KhoiPham2402/RISCV-VPU32x/report/acronyms.tex

%% acronyms.tex — Abbreviations used in the thesis
\newacronym{vpu}{VPU}{Vector Processing Unit}
\newacronym{isa}{ISA}{Instruction Set Architecture}
\newacronym{risc}{RISC}{Reduced Instruction Set Computer}
\newacronym{riscv}{RISC-V}{Reduced Instruction Set Computer V}
\newacronym{rtl}{RTL}{Register Transfer Level}
\newacronym{asic}{ASIC}{Application-Specific Integrated Circuit}
\newacronym{fpga}{FPGA}{Field-Programmable Gate Array}
\newacronym{rvv}{RVV}{RISC-V Vector Extension}
\newacronym{vlen}{VLEN}{Vector Register Length}
\newacronym{sew}{SEW}{Standard Element Width}
\newacronym{lmul}{LMUL}{Length MULtiplier}
\newacronym{vlmax}{VLMAX}{Maximum Vector Length}
\newacronym{vrf}{VRF}{Vector Register File}
\newacronym{vl}{VL}{Vector Length}
\newacronym{fsm}{FSM}{Finite State Machine}
\newacronym{fifo}{FIFO}{First-In First-Out}
\newacronym{lsu}{LSU}{Load/Store Unit}
\newacronym{vlsu}{VLSU}{Vector Load/Store Unit}
\newacronym{alu}{ALU}{Arithmetic Logic Unit}
\newacronym{uart}{UART}{Universal Asynchronous Receiver-Transmitter}
\newacronym{dmem}{DMEM}{Data Memory}
\newacronym{imem}{IMEM}{Instruction Memory}
\newacronym{csr}{CSR}{Control and Status Register}
\newacronym{simd}{SIMD}{Single Instruction Multiple Data}
\newacronym{agu}{AGU}{Address Generation Unit}
\newacronym{fmax}{Fmax}{Maximum Operating Frequency}
\newacronym{alm}{ALM}{Adaptive Logic Module}
\newacronym{sta}{STA}{Static Timing Analysis}
\newacronym{pnr}{PnR}{Place and Route}
\newacronym{drc}{DRC}{Design Rule Check}
\newacronym{lvs}{LVS}{Layout vs.\ Schematic}
\newacronym{gds}{GDS}{Graphic Design System}
\newacronym{hcmut}{HCMUT}{Ho Chi Minh City University of Technology}
\newacronym{tlu}{TL-UL}{TileLink Uncached Lightweight}
\newacronym{raw}{RAW}{Read After Write}
\newacronym{waw}{WAW}{Write After Write}
