KhoiPham2402/RISCV-VPU32x/fpga/sim/vga_frame_full.png

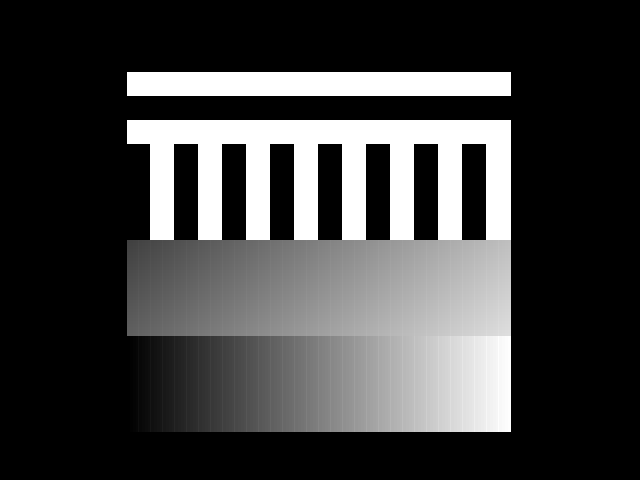
fpga/sim/vga_frame_full.png
