KhoiPham2402/RISCV-VPU32x/fpga/sim/vga_image_128.png

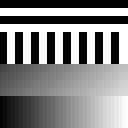
fpga/sim/vga_image_128.png
