KhoiPham2402/RISCV-VPU32x/image/vrf.png

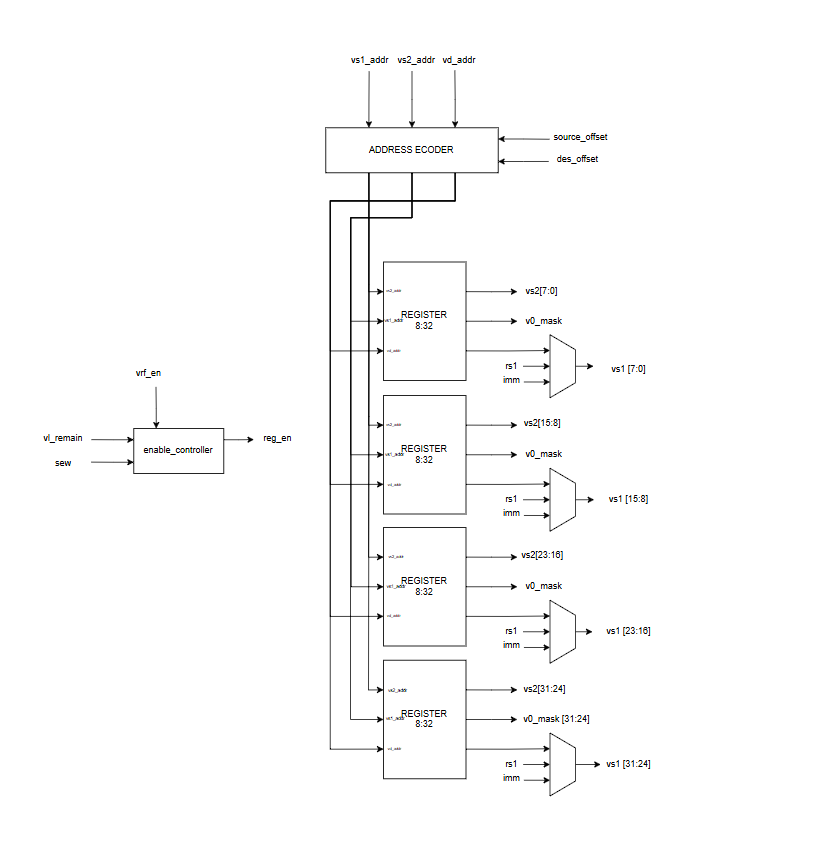
image/vrf.png
