KhoiPham2402/RISCV-VPU32x/report/charts/00_dashboard.png

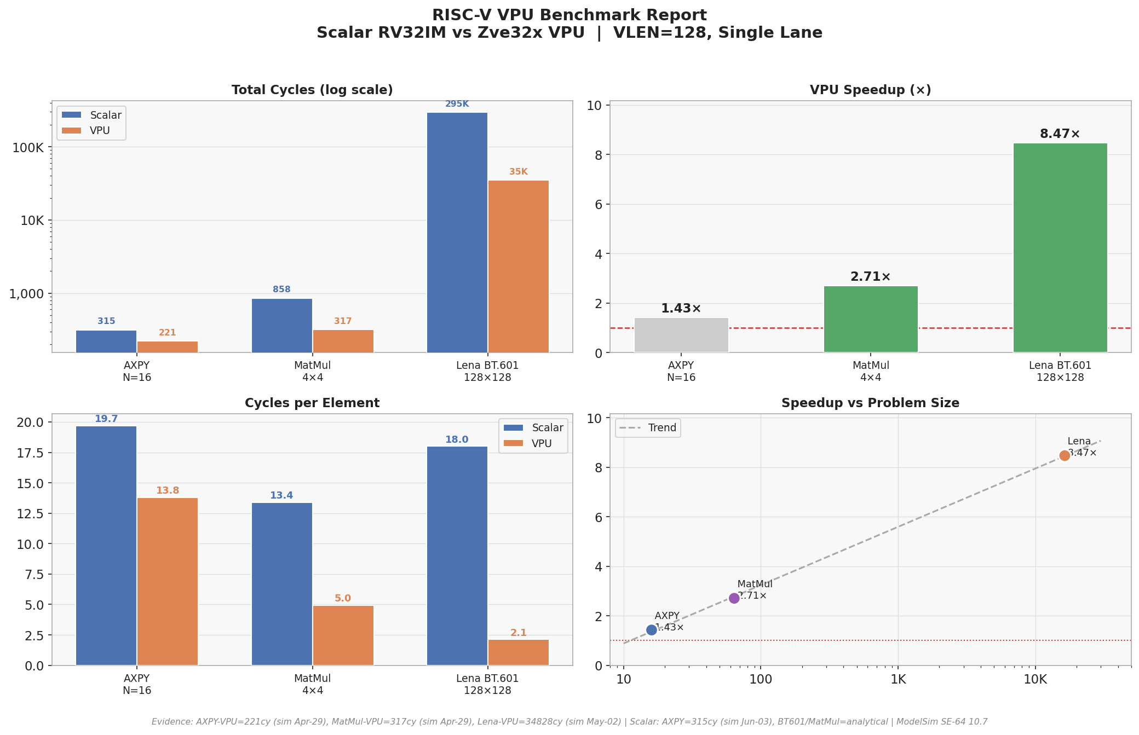
report/charts/00_dashboard.png
