KhoiPham2402/RISCV-VPU32x/report/charts/01_cycles_comparison.png

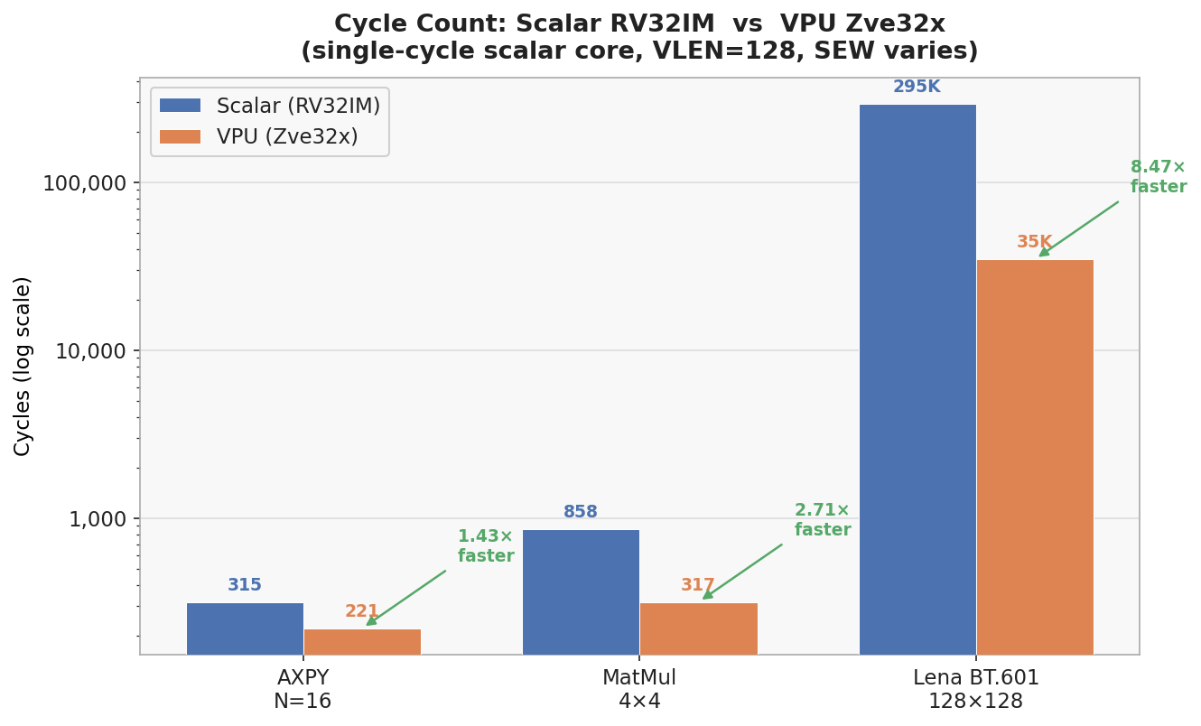
report/charts/01_cycles_comparison.png
