KhoiPham2402/RISCV-VPU32x/report/charts/02_speedup.png

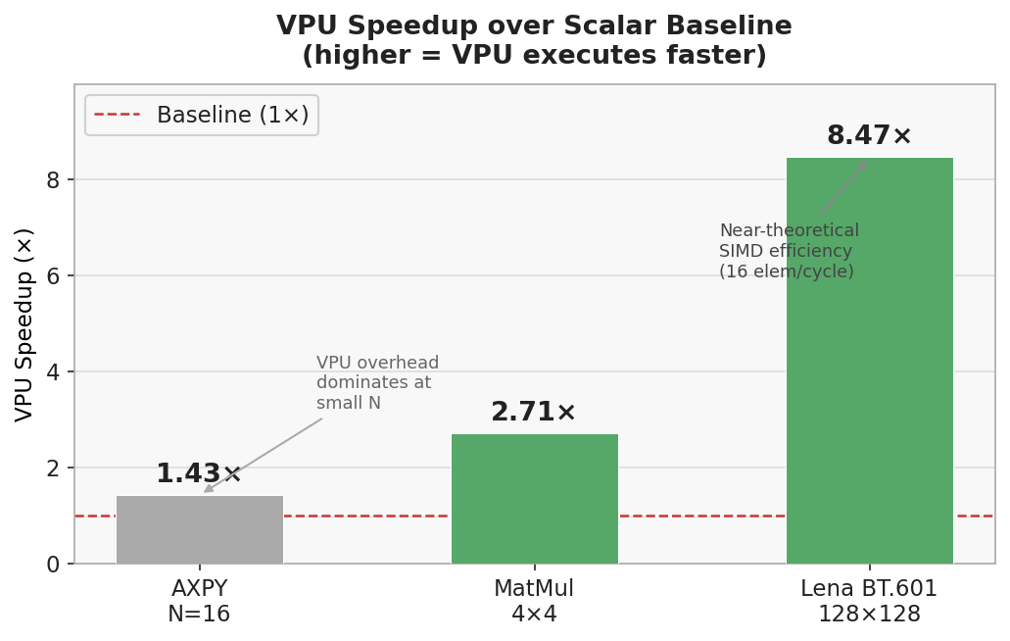
report/charts/02_speedup.png
