KhoiPham2402/RISCV-VPU32x/report/charts/03_throughput_per_elem.png

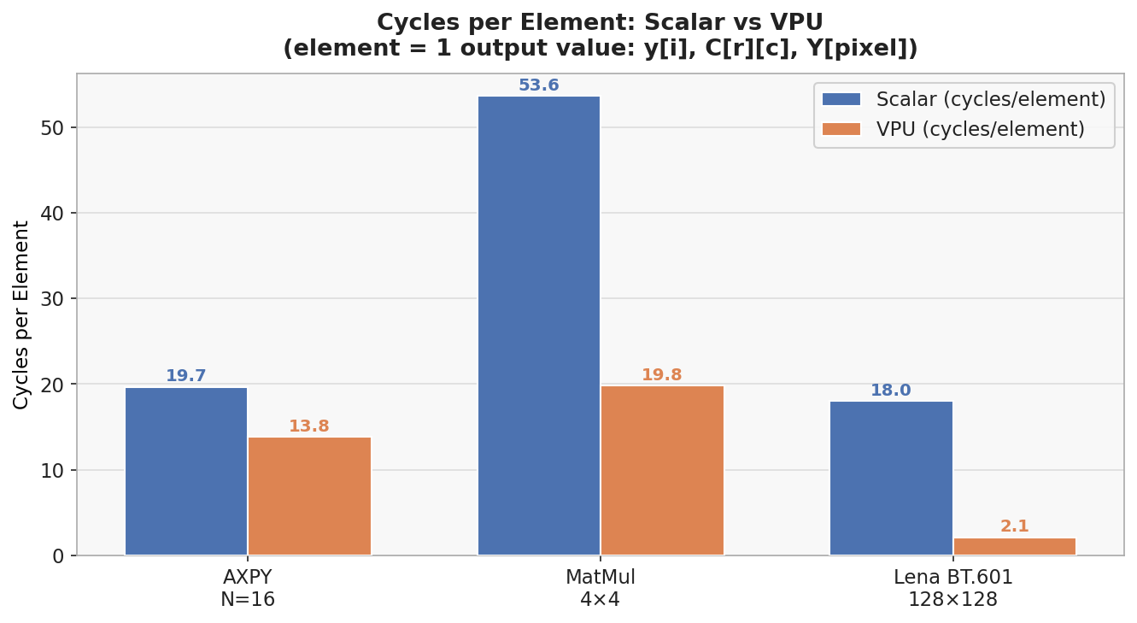
report/charts/03_throughput_per_elem.png
