KhoiPham2402/RISCV-VPU32x/report/charts/04_lena_breakdown.png

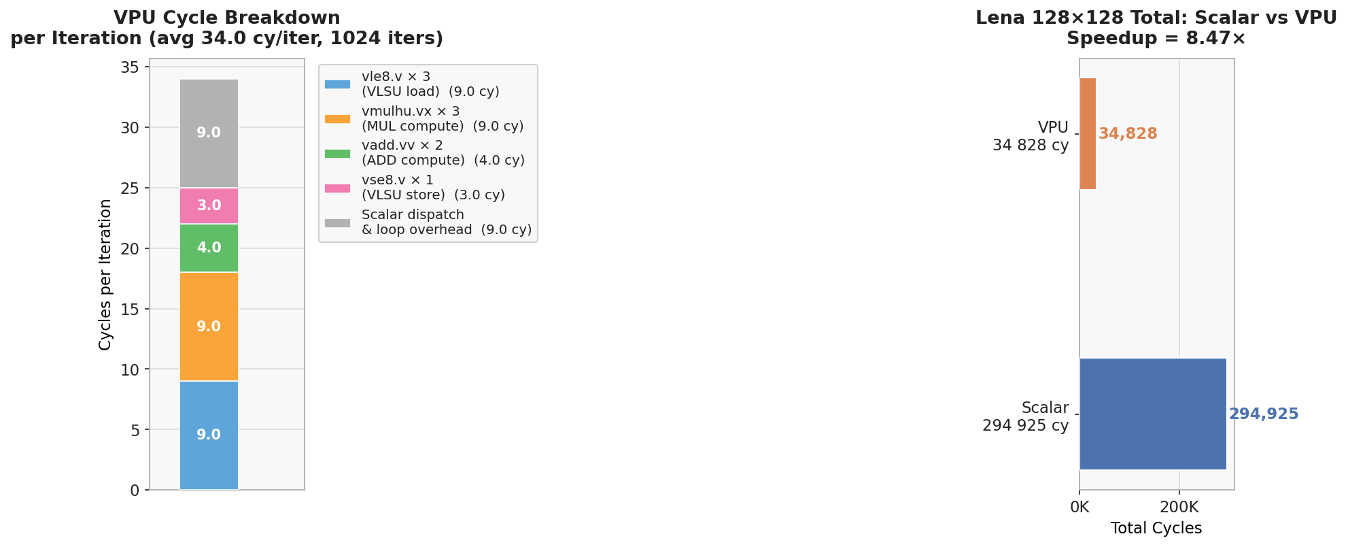
report/charts/04_lena_breakdown.png
