KhoiPham2402/RISCV-VPU32x/report/charts/05_speedup_vs_size.png

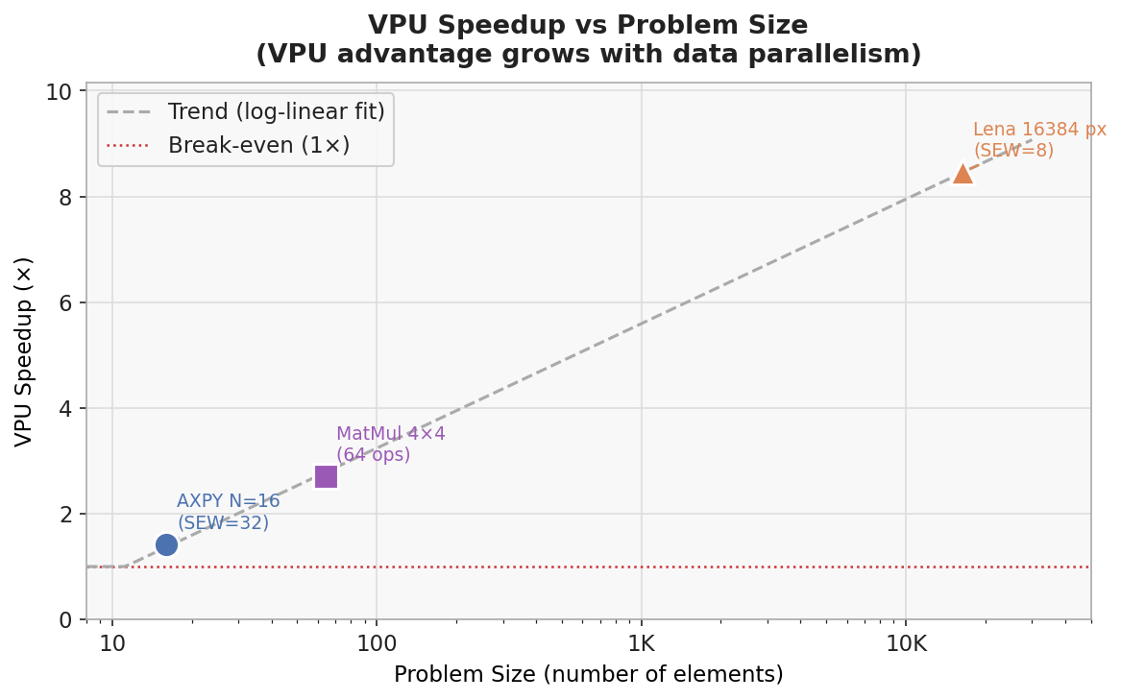
report/charts/05_speedup_vs_size.png
