KhoiPham2402/RISCV-VPU32x/report/image/dmem_lena_flow.png

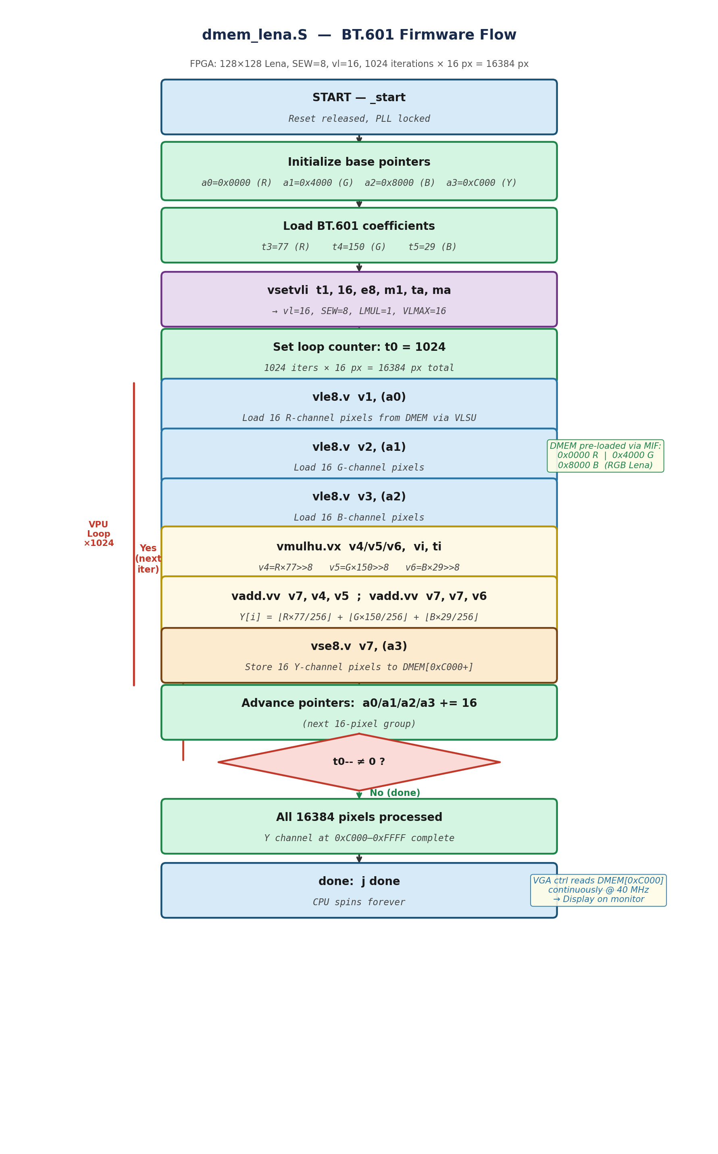
report/image/dmem_lena_flow.png
