KhoiPham2402/RISCV-VPU32x/report/charts/06_instruction_count.png

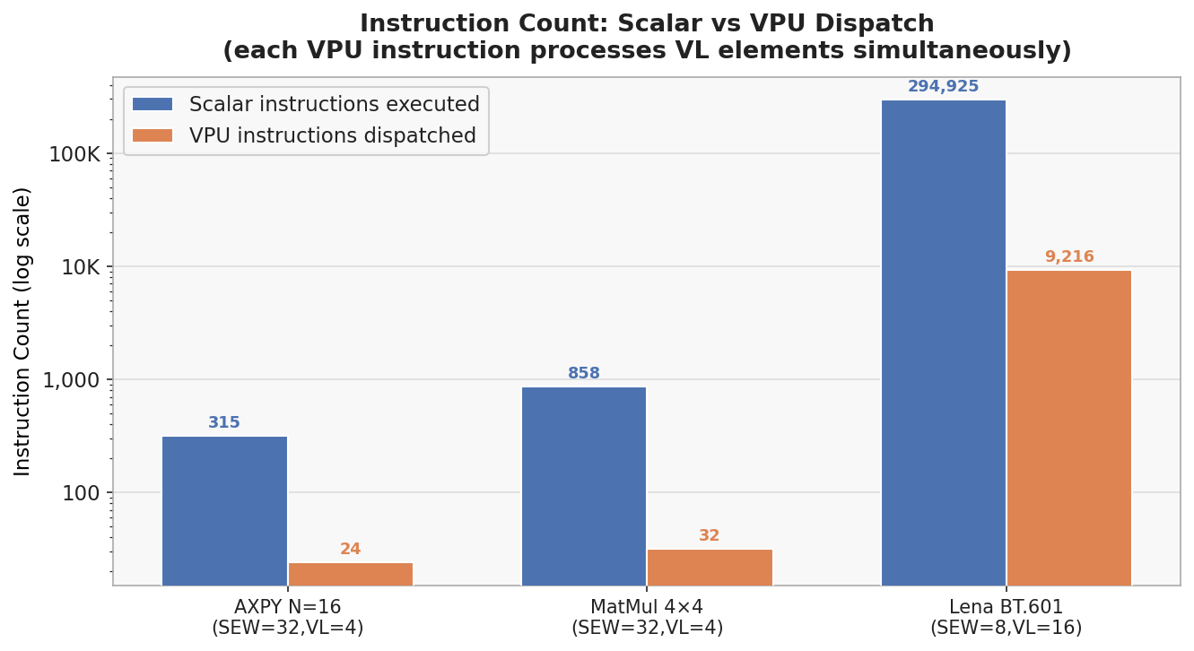
report/charts/06_instruction_count.png
