KhoiPham2402/RISCV-VPU32x/sw/benchmarks/pathfinder/README.md

# Pathfinder — NOT SUPPORTED

Pathfinder requires vslide1up.vx and vslide1down.vx (RVV section 16.3).
These instructions are part of the Zve32x subset but are NOT implemented
in this RTL version.

Status: blocked — see PROJECT_STATUS.md issue #13.
