KhoiPham2402/RISCV-VPU32x/bench/simulation_result.txt

# 
========================================
Compiling RTL modules...
========================================

Compiling testbench...
========================================

Starting simulation...
========================================
# do run_tb_lane.do
# ** Warning: (vlib-34) Library already exists at "work".
# Model Technology ModelSim - Intel FPGA Edition vmap 10.5b Lib Mapping Utility 2016.10 Oct  5 2016
# vmap work work 
# Copying C:/intelFPGA_lite/18.1/modelsim_ase/win32aloem/../modelsim.ini to modelsim.ini
# Modifying modelsim.ini
# Model Technology ModelSim - Intel FPGA Edition vlog 10.5b Compiler 2016.10 Oct  5 2016
# Start time: 22:01:40 on Mar 14,2026
# vlog -sv ../rtl/vproc_adder.sv 
# -- Compiling module vproc_adder
# 
# Top level modules:
# 	vproc_adder
# End time: 22:01:41 on Mar 14,2026, Elapsed time: 0:00:01
# Errors: 0, Warnings: 0
# Model Technology ModelSim - Intel FPGA Edition vlog 10.5b Compiler 2016.10 Oct  5 2016
# Start time: 22:01:41 on Mar 14,2026
# vlog -sv ../rtl/vproc_mul.sv 
# -- Compiling module vproc_mul
# 
# Top level modules:
# 	vproc_mul
# End time: 22:01:41 on Mar 14,2026, Elapsed time: 0:00:00
# Errors: 0, Warnings: 0
# Model Technology ModelSim - Intel FPGA Edition vlog 10.5b Compiler 2016.10 Oct  5 2016
# Start time: 22:01:41 on Mar 14,2026
# vlog -sv ../rtl/vproc_logic.sv 
# -- Compiling module vproc_logic
# 
# Top level modules:
# 	vproc_logic
# End time: 22:01:41 on Mar 14,2026, Elapsed time: 0:00:00
# Errors: 0, Warnings: 0
# Model Technology ModelSim - Intel FPGA Edition vlog 10.5b Compiler 2016.10 Oct  5 2016
# Start time: 22:01:41 on Mar 14,2026
# vlog -sv ../rtl/vproc_shifter.sv 
# -- Compiling module vproc_shifter
# 
# Top level modules:
# 	vproc_shifter
# End time: 22:01:41 on Mar 14,2026, Elapsed time: 0:00:00
# Errors: 0, Warnings: 0
# Model Technology ModelSim - Intel FPGA Edition vlog 10.5b Compiler 2016.10 Oct  5 2016
# Start time: 22:01:41 on Mar 14,2026
# vlog -sv ../rtl/vproc_compare.sv 
# -- Compiling module vproc_compare
# 
# Top level modules:
# 	vproc_compare
# End time: 22:01:41 on Mar 14,2026, Elapsed time: 0:00:00
# Errors: 0, Warnings: 0
# Model Technology ModelSim - Intel FPGA Edition vlog 10.5b Compiler 2016.10 Oct  5 2016
# Start time: 22:01:41 on Mar 14,2026
# vlog -sv ../rtl/vproc_processor_lane.sv 
# -- Compiling module vproc_processor_lane
# ** Error: (vlog-13069) ../rtl/vproc_processor_lane.sv(216): near ",": syntax error, unexpected ',', expecting '}'.
# ** Error: (vlog-13069) ../rtl/vproc_processor_lane.sv(221): near ",": syntax error, unexpected ',', expecting '}'.
# End time: 22:01:41 on Mar 14,2026, Elapsed time: 0:00:00
# Errors: 2, Warnings: 0
# ** Error: C:/intelFPGA_lite/18.1/modelsim_ase/win32aloem/vlog failed.
# Error in macro ./run_tb_lane.do line 16
# C:/intelFPGA_lite/18.1/modelsim_ase/win32aloem/vlog failed.
#     while executing
# "vlog -sv ../rtl/vproc_processor_lane.sv"
# Model Technology ModelSim - Intel FPGA Edition vlog 10.5b Compiler 2016.10 Oct  5 2016
# Start time: 22:01:41 on Mar 14,2026
# vlog -sv tb_vproc_lane.sv 
# -- Compiling module tb_vproc_lane
# ** Error: (vlog-13069) tb_vproc_lane.sv(269): near ",": syntax error, unexpected ',', expecting '}'.
# ** Error: (vlog-13069) tb_vproc_lane.sv(284): near ",": syntax error, unexpected ',', expecting '}'.
# End time: 22:01:41 on Mar 14,2026, Elapsed time: 0:00:00
# Errors: 2, Warnings: 0
# ** Error: C:/intelFPGA_lite/18.1/modelsim_ase/win32aloem/vlog failed.
# Error in macro ./run_tb_lane.do line 21
# C:/intelFPGA_lite/18.1/modelsim_ase/win32aloem/vlog failed.
#     while executing
# "vlog -sv tb_vproc_lane.sv"
# vsim -novopt work.tb_vproc_lane 
# Start time: 22:01:39 on Mar 14,2026
# ** Error: (vsim-3170) Could not find 'tb_vproc_lane'.
#         Searched libraries:
#             C:/CapstoneProject2/riscv_vpu/bench/work
# ** Error: Error loading design
# Error in macro ./run_tb_lane.do line 26
# Error loading design
#     while executing
# "vsim -novopt work.tb_vproc_lane"

Running testbench...
# No Design Loaded!
# Error in macro ./run_tb_lane.do line 30
# 
#     while executing
# "run -all"

Simulation completed!
# End time: 22:01:41 on Mar 14,2026, Elapsed time: 0:00:02
# Errors: 14, Warnings: 1
