KhoiPham2402/RISCV-VPU32x/sw/benchmarks/lena_gray/lena_comparison.png

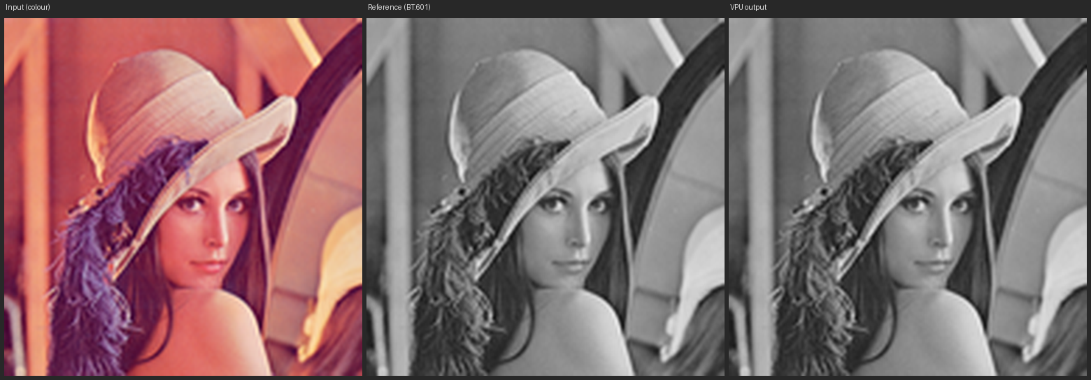
sw/benchmarks/lena_gray/lena_comparison.png
