KhoiPham2402/RISCV-VPU32x/sw/benchmarks/sobel/sobel_comparison.png

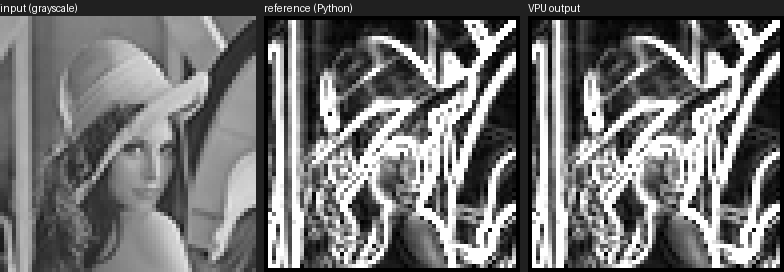
sw/benchmarks/sobel/sobel_comparison.png
