KhoiPham2402/RISCV-VPU32x/fpga/rtl/vpu/vproc_system_wrapper.sv

// Top-level wrapper tích hợp:
//   decoder -> fifo -> fsm
//   cfg_encoder + cycle_counter + 4x vregfile + 4x processor_lane + vcsr
//
// vmask16 = cửa sổ mask sau mux structural (vproc_mask_enable).
// v0_flat ghép 128b từ mask_data v0 của 4 lane; mask_cycle_idx từ cycle_counter.

module vproc_system_wrapper #(
    parameter NUM_REGS   = 32,
    parameter ADDR_WIDTH = 5,
    parameter CTRL_WIDTH = 49
) (
    input                   clk,
    input                   rst_n,

    // Issue interface
    input                   instr_valid,
    input  [31:0]           instruction,
    input  [31:0]           rs1_scalar_data, // avl / rs1 scalar
    input  [31:0]           rs2_scalar_data, // dùng cho vsetvl lấy vtype từ rs2

    // VRF write control
    input                   vrf_commit_en,

    // Outputs debug/quan sát
    output [3:0]            cycles,
    output [15:0]           vmask16,
    output                  fifo_full,
    output                  busy,
    output [3:0]            fsm_state,
    output [31:0]           wb_result_lane0,
    output [31:0]           wb_result_lane1,
    output [31:0]           wb_result_lane2,
    output [31:0]           wb_result_lane3,

    // Handshake back to scalar core
    output                  vpu_ready,

    // Config writeback (vl remaining for scalar rd)
    output                  vpu_cfg_done,
    output [31:0]           vpu_vl_remain,

    // CSR vector (debug / quan sát thanh ghi)
    output [31:0]           csr_vl_o,
    output [31:0]           csr_vtype_o,
    output [31:0]           csr_vlenb_o,

    // Cổng đọc CSR theo địa chỉ (từ scalar inst[31:20])
    input  [11:0]           scalar_csr_addr,
    output [31:0]           scalar_csr_rdata,

    // ── VLSU shared DMEM bus (routed to secondary port of scalar lsu.sv) ──
    output                  vlsu_mem_req,
    output                  vlsu_mem_we,
    output [31:0]           vlsu_mem_addr,
    output [ 3:0]           vlsu_mem_be,
    output [31:0]           vlsu_mem_wdata,
    input  [31:0]           vlsu_mem_rdata,
    input                   vlsu_mem_ready,  // from dmem_sync vlsu_ready (1-cyc read latency ack)

    // VLSU status (for stall signaling back to scalar core via vpu_ready)
    output                  vlsu_busy_o
);

    // ===== Decoder -> FIFO =====
    wire [CTRL_WIDTH-1:0] dec_ctrl_bus;
    wire                  dec_valid;
    wire [31:0]           dec_imm_out;

    wire [CTRL_WIDTH-1:0] fifo_ctrl_out;
    wire [31:0]           fifo_rs1_out;
    wire [31:0]           fifo_imm_out;
    wire                  fifo_data_valid;

    // ===== FSM signals =====
    wire fsm_latch_ctrl_en;
    wire fsm_csr_cfg_en;
    wire fsm_counter_start;
    wire fsm_vrf_wren;
    wire fsm_widen_sel;
    wire fsm_s_offset_en;
    wire fsm_d_offset_en;
    wire fsm_offset_reset;
    wire fsm_pop_ready;
    wire fsm_reduction_start;
    wire fsm_reduction_en;
    wire red_busy;

    // ===== Latched instruction/context (chốt bởi FSM) =====
    reg [CTRL_WIDTH-1:0] ctrl_r;
    reg [31:0]           rs1_latched_r;
    reg [31:0]           imm_latched_r;

    // Field extraction từ ctrl_r
    wire [ADDR_WIDTH-1:0] vs1_addr_base_r = ctrl_r[4:0];
    wire [ADDR_WIDTH-1:0] vs2_addr_base_r = ctrl_r[9:5];
    wire [ADDR_WIDTH-1:0] vd_addr_base_r  = ctrl_r[14:10];
    wire [5:0]            funct6_r   = ctrl_r[20:15];
    wire                  is_widen_r = ctrl_r[21];
    wire                  is_u_vs1_r = ctrl_r[22];
    wire                  is_u_vs2_r = ctrl_r[23];
    wire                  sub_r      = ctrl_r[24];
    wire                  use_imm_r  = ctrl_r[25];
    wire                  use_rs1_r  = ctrl_r[26];
    wire                  is_mulh_r  = ctrl_r[27];
    wire                  vm_r       = ctrl_r[31];
    wire [7:0]            vtype_enc_r = ctrl_r[39:32];
    wire                  is_carry_r      = ctrl_r[40];
    wire                  is_mask_carry_r = ctrl_r[41];
    wire                  is_masking_r    = ctrl_r[42];
    wire                  is_final_masking_r = ctrl_r[43];
    wire                  is_reverse_sub_r   = ctrl_r[44];
    wire                  minmax_is_min_r    = ctrl_r[45];
    wire                  minmax_is_unsign_r = ctrl_r[46];
    wire                  is_reduction_r     = ctrl_r[47];

    // ===== CFG encoder outputs =====
    wire [31:0] cfg_vl;
    wire [31:0] cfg_vlmax;
    wire [2:0]  cfg_sew;
    wire        cfg_vill;
    wire [31:0] cfg_avl_remain;

    // ===== Cycle counter related =====
    wire       counter_done;
    wire [3:0] cycles_left_dbg;
    wire [7:0] elems_curr_cycle_dbg;
    wire [15:0] cycle_mask16_dbg;
    wire [3:0]  mask_cycle_idx;

    // ===== VRF read data per lane =====
    wire [31:0] rs1_data_lane0, rs2_data_lane0;
    wire [31:0] rs1_data_lane1, rs2_data_lane1;
    wire [31:0] rs1_data_lane2, rs2_data_lane2;
    wire [31:0] rs1_data_lane3, rs2_data_lane3;
    wire [31:0] mask_data_lane0, mask_data_lane1, mask_data_lane2, mask_data_lane3;
    wire [127:0] v0_mask_flat = {mask_data_lane3, mask_data_lane2,
                                  mask_data_lane1, mask_data_lane0};

    // ===== Internal writeback per lane =====
    wire [31:0] wb_lane0, wb_lane1, wb_lane2, wb_lane3;
    wire [3:0]  lane_mask_result0, lane_mask_result1, lane_mask_result2, lane_mask_result3;
    wire [3:0]  lane_mask0, lane_mask1, lane_mask2, lane_mask3;
    wire [3:0]  lane_we0, lane_we1, lane_we2, lane_we3;
    wire [31:0] lane0_v0_merge_bits, lane1_v0_merge_bits, lane2_v0_merge_bits, lane3_v0_merge_bits;
    wire [ADDR_WIDTH-1:0] vs1_addr_eff, vs2_addr_eff, vd_addr_eff;
    wire [31:0] imm_elem_vec;
    wire [31:0] rs1_elem_vec;
    wire        is_compare_r = (funct6_r[5:3] == 3'b011);
    wire [127:0] mask_buffer_data;
    wire [6:0]   mask_wr_ptr_dbg;
    wire         final_masking_commit = (fsm_state == 3'd6) && is_final_masking_r;
    wire         reduction_commit = (fsm_state == 4'd8) && is_reduction_r;
    wire [127:0] rs1_vec_flat = {rs1_data_lane3, rs1_data_lane2, rs1_data_lane1, rs1_data_lane0};
    wire [127:0] rs2_vec_flat = {rs2_data_lane3, rs2_data_lane2, rs2_data_lane1, rs2_data_lane0};
    wire [31:0]  reduction_result;
    wire         reduction_wb_valid;
    reg [3:0]    reduction_operation;
    localparam [3:0] RED_SUM  = 4'd0;
    localparam [3:0] RED_MAX  = 4'd1;
    localparam [3:0] RED_MAXU = 4'd2;
    localparam [3:0] RED_MIN  = 4'd3;
    localparam [3:0] RED_MINU = 4'd4;
    localparam [3:0] RED_AND  = 4'd5;
    localparam [3:0] RED_OR   = 4'd6;
    localparam [3:0] RED_XOR  = 4'd7;
    // Final masking: commit toàn bộ 128-bit buffer về 4 lane (mỗi lane 32-bit).
    wire [31:0]  wb_lane0_mux = final_masking_commit ? mask_buffer_data[31:0]    : wb_lane0;
    wire [31:0]  wb_lane1_mux = final_masking_commit ? mask_buffer_data[63:32]   : wb_lane1;
    wire [31:0]  wb_lane2_mux = final_masking_commit ? mask_buffer_data[95:64]   : wb_lane2;
    wire [31:0]  wb_lane3_mux = final_masking_commit ? mask_buffer_data[127:96]  : wb_lane3;
    wire [3:0]   lane_we0_mux = final_masking_commit ? 4'b1111 : (lane_we0 & cycle_mask16_dbg[3:0]);
    wire [3:0]   lane_we1_mux = final_masking_commit ? 4'b1111 : (lane_we1 & cycle_mask16_dbg[7:4]);
    wire [3:0]   lane_we2_mux = final_masking_commit ? 4'b1111 : (lane_we2 & cycle_mask16_dbg[11:8]);
    wire [3:0]   lane_we3_mux = final_masking_commit ? 4'b1111 : (lane_we3 & cycle_mask16_dbg[15:12]);

    // =========================================================================
    // VLSU — Vector Load/Store Unit signals
    // =========================================================================

    // VLS instruction decode (combinational, parallel to FIFO path for OP-V)
    // LOAD-FP opcode [6:2] = 5'b00001  (0000111)
    // STORE-FP opcode [6:2] = 5'b01001 (0100111)
    wire is_vls_load_raw  = (instruction[6:2] == 5'b00001);
    wire is_vls_store_raw = (instruction[6:2] == 5'b01001);
    wire is_vls_unit_stride = (instruction[27:26] == 2'b00);    // mop=00 (unit-stride)
    wire is_vls_regular     = (instruction[24:20] == 5'b00000); // lumop/sumop=00000 (regular)
    wire is_vls_insn = (is_vls_load_raw || is_vls_store_raw) && is_vls_unit_stride && is_vls_regular;

    // Convert instruction width field [14:12] to 2-bit SEW encoding
    //   000 → e8  (sew=0), 101 → e16 (sew=1), 110 → e32 (sew=2)
    reg [1:0] vls_sew_dec;
    always_comb begin
        case (instruction[14:12])
            3'b000:  vls_sew_dec = 2'd0;
            3'b101:  vls_sew_dec = 2'd1;
            3'b110:  vls_sew_dec = 2'd2;
            default: vls_sew_dec = 2'd2;
        endcase
    end

    // ── Dispatcher hazard signals (forward-declared; resolved when FSM/addrgen elaborate) ──
    wire vlsu_busy_int;     // from VLSU instance
    wire vlsu_busy_store_int;
    wire fifo_or_fsm_busy = fifo_data_valid || busy;

    // WAW guard: block load from firing while OP-V FSM is writing OR has a pending
    // instruction in the FIFO that targets the same vd.
    // Gap in original: busy=0 when FIFO has instruction but FSM hasn't latched it yet,
    // allowing a load to fire in the same cycle the FSM transitions to ST_EXEC.
    // Fix: when FSM is idle but FIFO has data, compare against FIFO head vd (fifo_ctrl_out[14:10]).
    wire [4:0] pending_vd_addr = busy ? vd_addr_eff : fifo_ctrl_out[14:10];
    wire load_waw_stall = instr_valid && is_vls_load_raw
                          && is_vls_unit_stride && is_vls_regular
                          && (busy || fifo_data_valid)
                          && (pending_vd_addr == instruction[11:7]);

    // CSR stall: a load sees stale csr_vl_o=0 if vsetvli is still in FSM or FIFO.
    // Declared here (before vls_fire) because both vls_fire and vpu_ready use it.
    wire vsetvli_pending   = fsm_csr_cfg_en || (fifo_data_valid && fifo_ctrl_out[28]);
    wire is_load_csr_stall = instr_valid && is_vls_load_raw && vsetvli_pending;

    // Dispatcher: fire VLSU when:
    //   - instruction valid, recognised VLS, VLSU free
    //   - STORE: OP-V pipeline fully drained (WAR: vs2 port no longer hijacked)
    //   - LOAD:  OP-V FSM not writing same vd (WAW: VRF write-port conflict)
    //   - LOAD:  vsetvli not pending (CSR stall guard — see is_load_csr_stall)
    wire vls_fire = instr_valid && is_vls_insn && !vlsu_busy_int
                    && (!is_vls_store_raw || !fifo_or_fsm_busy)
                    && !load_waw_stall
                    && !is_load_csr_stall;

    // Track whether the running VLSU op is a load (for VRF vs2 mux)
    reg vlsu_is_load_r;
    always_ff @(posedge clk) begin
        if (!rst_n)         vlsu_is_load_r <= 1'b1;
        else if (vls_fire)  vlsu_is_load_r <= is_vls_load_raw;
    end

    // VLSU VRF writeback wires — declared here so scoreboard can reference them
    wire        vlsu_vrf_we;
    wire [4:0]  vlsu_vrf_waddr;

    // ── Scoreboard: RAW hazard (OP-V reads register being loaded by VLSU) ──
    // vrf_busy_r[i]=1 means VRF[i] has an in-flight VLSU load writing to it.
    // FSM must not execute any OP-V instruction whose vs1/vs2 is marked busy.
    reg [31:0] vrf_busy_r;
    always_ff @(posedge clk) begin
        if (!rst_n) begin
            vrf_busy_r <= 32'b0;
        end else begin
            if (vls_fire && is_vls_load_raw)
                vrf_busy_r[instruction[11:7]] <= 1'b1;   // mark load dest busy
            if (vlsu_vrf_we)
                vrf_busy_r[vlsu_vrf_waddr] <= 1'b0;      // clear when load commits
        end
    end

    // Head-of-FIFO source registers (ctrl_bus layout: vs1=[4:0], vs2=[9:5])
    wire [4:0] fifo_vs1_addr = fifo_ctrl_out[4:0];
    wire [4:0] fifo_vs2_addr = fifo_ctrl_out[9:5];
    wire [4:0] load_vd_addr  = instruction[11:7];

    // Same-cycle check: vrf_busy_r is registered so it won't reflect a load
    // that fires THIS cycle — catch it combinationally.
    wire cur_load_raw = vls_fire && is_vls_load_raw &&
                        (load_vd_addr == fifo_vs1_addr ||
                         load_vd_addr == fifo_vs2_addr);

    // RAW stall: hold FSM in ST_IDLE until the conflicting load finishes.
    wire raw_stall = fifo_data_valid &&
                     (vrf_busy_r[fifo_vs1_addr] ||
                      vrf_busy_r[fifo_vs2_addr] ||
                      cur_load_raw);
    wire [31:0] vlsu_vrf_wdata_l0, vlsu_vrf_wdata_l1;
    wire [31:0] vlsu_vrf_wdata_l2, vlsu_vrf_wdata_l3;

    // VRF vs2 address mux: during VLSU store, override with vlsu_vrf_raddr
    wire [4:0]  vlsu_vrf_raddr_int;
    wire [4:0]  vs2_addr_to_vrf = (vlsu_busy_int && !vlsu_is_load_r)
                                    ? vlsu_vrf_raddr_int
                                    : vs2_addr_eff;

    // VRF write-port mux: VLSU wins over ALU pipeline (FSM is idle during VLSU)
    wire [4:0]  vrf_waddr_eff   = vlsu_vrf_we ? vlsu_vrf_waddr   : vd_addr_eff;
    wire [31:0] vrf_wdata0_eff  = vlsu_vrf_we ? vlsu_vrf_wdata_l0
                                               : (reduction_commit ? reduction_result : wb_lane0_mux);
    wire [31:0] vrf_wdata1_eff  = vlsu_vrf_we ? vlsu_vrf_wdata_l1 : wb_lane1_mux;
    wire [31:0] vrf_wdata2_eff  = vlsu_vrf_we ? vlsu_vrf_wdata_l2 : wb_lane2_mux;
    wire [31:0] vrf_wdata3_eff  = vlsu_vrf_we ? vlsu_vrf_wdata_l3 : wb_lane3_mux;

    wire [3:0] vrf_we0_eff = vlsu_vrf_we ? 4'b1111
                           : ((vrf_commit_en && fsm_vrf_wren)
                              ? (reduction_commit ? 4'b1111 : lane_we0_mux) : 4'b0000);
    wire [3:0] vrf_we1_eff = vlsu_vrf_we ? 4'b1111
                           : ((vrf_commit_en && fsm_vrf_wren)
                              ? (reduction_commit ? 4'b0000 : lane_we1_mux) : 4'b0000);
    wire [3:0] vrf_we2_eff = vlsu_vrf_we ? 4'b1111
                           : ((vrf_commit_en && fsm_vrf_wren)
                              ? (reduction_commit ? 4'b0000 : lane_we2_mux) : 4'b0000);
    wire [3:0] vrf_we3_eff = vlsu_vrf_we ? 4'b1111
                           : ((vrf_commit_en && fsm_vrf_wren)
                              ? (reduction_commit ? 4'b0000 : lane_we3_mux) : 4'b0000);

    // ===== Decoder =====
    vproc_vdecoder #(
        .BASE_ADDR (ADDR_WIDTH),
        .CTRL_WIDTH(CTRL_WIDTH)
    ) decoder_inst (
        .instruction(instruction),
        .rs2_data   (rs2_scalar_data),
        .ctrl_bus   (dec_ctrl_bus),
        .imm_out    (dec_imm_out),
        .valid      (dec_valid)
    );

    // ===== FIFO =====
    vproc_fifo #(
        .CTRL_WIDTH(CTRL_WIDTH),
        .RS1_WIDTH (32),
        .IMM_WIDTH (32),
        .DEPTH     (8),
        .ADDR_W    (3)
    ) fifo_inst (
        .clk       (clk),
        .rst_n     (rst_n),
        // Config (vsetvli): push whenever FIFO has space — must not wait for vlsu_busy.
        // Arithmetic OP-V: only push when vpu_ready (prevents duplicate FIFO pushes on stall).
        .push_valid(instr_valid && dec_valid &&
                    (dec_ctrl_bus[28] ? ~fifo_full : vpu_ready)),
        .ctrl_in   (dec_ctrl_bus),
        .rs1_in    (rs1_scalar_data),
        .imm_in    (dec_imm_out),
        .full      (fifo_full),
        .ctrl_out  (fifo_ctrl_out),
        .rs1_out   (fifo_rs1_out),
        .imm_out   (fifo_imm_out),
        .data_valid(fifo_data_valid),
        .pop_ready (fsm_pop_ready)
    );

    // vpu_ready: stall scalar core for:
    //   - FIFO full (backpressure from OP-V queue)
    //   - VLSU busy (ongoing load or store)
    //   - STORE presented while OP-V pipeline draining (WAR guard)
    //   - LOAD presented while OP-V FSM writing same vd (WAW guard)
    //   - LOAD presented while vsetvli is pending (CSR stall guard):
    //     A vle*/vse* fires with csr_vl_o; if vsetvli is still in FSM (ST_CONFIG)
    //     or in the FIFO head, csr_vl_o may be stale (0 from reset). Stall the
    //     scalar so the load does not fire until VL is committed.
    wire is_store_stall = instr_valid && is_vls_store_raw
                          && is_vls_unit_stride && is_vls_regular
                          && fifo_or_fsm_busy;
    assign vpu_ready     = ~fifo_full && ~vlsu_busy_int
                           && ~is_store_stall && ~load_waw_stall
                           && ~is_load_csr_stall;
    assign vlsu_busy_o   = vlsu_busy_int;
    assign vpu_cfg_done  = fsm_csr_cfg_en;
    // Write actual vl (= min(avl, vlmax)) to scalar rd, NOT avl_remain.
    // avl_remain was the bug: for avl=16, vlmax=4 it gave 12 instead of 4.
    assign vpu_vl_remain = cfg_vl;

    // ===== FSM =====
    vproc_fsm fsm_inst (
        .clk          (clk),
        .rst_n        (rst_n),
        .instr_valid  (fifo_data_valid && !raw_stall),  // RAW stall gates FSM
        .is_config    (fifo_ctrl_out[28]),
        .is_masking   (fifo_ctrl_out[42]),
        .is_widen     (fifo_ctrl_out[21]),
        .is_reduction (fifo_ctrl_out[47]),
        .counter_done (counter_done),
        .reduction_done(reduction_wb_valid),
        .reduction_busy(red_busy),
        .latch_ctrl_en(fsm_latch_ctrl_en),
        .csr_cfg_en   (fsm_csr_cfg_en),
        .counter_start(fsm_counter_start),
        .vrf_wren     (fsm_vrf_wren),
        .widen_sel    (fsm_widen_sel),
        .s_offset_en  (fsm_s_offset_en),
        .d_offset_en  (fsm_d_offset_en),
        .offset_reset (fsm_offset_reset),
        .pop_ready    (fsm_pop_ready),
        .reduction_start(fsm_reduction_start),
        .reduction_en (fsm_reduction_en),
        .busy         (busy),
        .state_out    (fsm_state)
    );

    // Chốt control + scalar(avl/rs1) + immediate vào thanh ghi tạm
    // chỉ khi FSM phát latch_ctrl_en.
    always_ff @(posedge clk) begin
        if (!rst_n) begin
            ctrl_r       <= {CTRL_WIDTH{1'b0}};
            rs1_latched_r <= 32'd0;
            imm_latched_r <= 32'd0;
        end else if (fsm_latch_ctrl_en) begin
            ctrl_r       <= fifo_ctrl_out;
            rs1_latched_r <= fifo_rs1_out;
            imm_latched_r <= fifo_imm_out;
        end
    end

    // Expand imm và rs1 scalar theo sew (module dùng chung).
    vproc_scalar_expand imm_expand_inst (
        .data_in (imm_latched_r),
        .sew     (cfg_sew),
        .data_out(imm_elem_vec)
    );

    vproc_scalar_expand rs1_expand_inst (
        .data_in (rs1_latched_r),
        .sew     (cfg_sew),
        .data_out(rs1_elem_vec)
    );

    // EXEC dùng cấu hình đã lưu trong CSR; riêng lệnh CONFIG dùng vtype từ instruction hiện tại.
    wire [7:0] vtype_active = ctrl_r[28] ? vtype_enc_r : csr_vtype_o[7:0];

    // For vsetivli (ctrl_r[48]=1) the AVL is the 5-bit immediate in vs1_addr,
    // not the latched scalar rs1 register value.
    wire [31:0] cfg_avl_src = ctrl_r[48] ? {27'b0, ctrl_r[4:0]} : rs1_latched_r;

    // ===== Config encoder =====
    vproc_cfg_encoder cfg_enc_inst (
        .vtype_enc  (vtype_active),
        .avl        (cfg_avl_src),
        .vl         (cfg_vl),
        .vlmax      (cfg_vlmax),
        .avl_remain (cfg_avl_remain),
        .sew        (cfg_sew),
        .vill       (cfg_vill)
    );

    // ===== Cycle counter =====
    vproc_cycle_counter cycle_counter_inst (
        .clk            (clk),
        .rst_n          (rst_n),
        .start          (fsm_counter_start),
        .enable         (fsm_s_offset_en),
        // Use CSR vl for non-config ops; config never triggers counter_start so cfg_vl is unused there
        .vl             (csr_vl_o),
        .vsew           (vtype_active[5:3]),
        .vlmul          (vtype_active[2:0]),
        .cycles_total   (cycles),
        .cycles_left    (cycles_left_dbg),
        .elems_curr_cycle(elems_curr_cycle_dbg),
        .cycle_mask16   (cycle_mask16_dbg),
        .cycle_index    (mask_cycle_idx),
        .done           (counter_done)
    );

    // ===== VRF address generator =====
    // Địa chỉ nguồn/đích tự tăng theo LMUL group.
    // Với widening: vd dùng offset nhân đôi + chọn pha bởi widen_sel.
    vproc_vrf_addr_gen #(
        .ADDR_WIDTH(ADDR_WIDTH)
    ) vrf_addr_gen_inst (
        .clk         (clk),
        .rst_n       (rst_n),
        .s_offset_enable(fsm_s_offset_en),
        .d_offset_enable(fsm_d_offset_en),
        .offset_clear(fsm_offset_reset),
        .vs1_base    (vs1_addr_base_r),
        .vs2_base    (vs2_addr_base_r),
        .vd_base     (vd_addr_base_r),
        .vs1_addr    (vs1_addr_eff),
        .vs2_addr    (vs2_addr_eff),
        .vd_addr     (vd_addr_eff)
    );

    // ===== CSR (simple 3-register) =====
    // vtype_enc từ FIFO đã chốt + avl từ rs1_latched_r -> cfg_encoder tính vl.
    // Khi FSM ở CONFIG, cfg_en=1 và csr lưu lại vl + vtype.
    vproc_vcsr vcsr_inst (
        .clk          (clk),
        .rst_n        (rst_n),
        .cfg_en       (fsm_csr_cfg_en),
        .vl_in        (cfg_vl),
        .vtype_enc_in (vtype_enc_r),
        .csr_addr     (scalar_csr_addr),
        .csr_rdata    (scalar_csr_rdata),
        .vl_o         (csr_vl_o),
        .vtype_o      (csr_vtype_o),
        .vlenb_o      (csr_vlenb_o)
    );

    // ===== Mask logic (mux structural trên v0_flat + sew + cycle_index) =====
    wire [3:0] lane0_v0_carry, lane1_v0_carry, lane2_v0_carry, lane3_v0_carry;

    vproc_mask_enable mask_enable_inst (
        .v0_flat         (v0_mask_flat),
        .sew             (cfg_sew),
        .mask_cycle_idx  (mask_cycle_idx[2:0]),
        .vm              (vm_r),
        .mask16_window   (vmask16),
        .lane0_mask      (lane_mask0),
        .lane1_mask      (lane_mask1),
        .lane2_mask      (lane_mask2),
        .lane3_mask      (lane_mask3),
        .lane0_we        (lane_we0),
        .lane1_we        (lane_we1),
        .lane2_we        (lane_we2),
        .lane3_we        (lane_we3),
        .lane0_v0_carry  (lane0_v0_carry),
        .lane1_v0_carry  (lane1_v0_carry),
        .lane2_v0_carry  (lane2_v0_carry),
        .lane3_v0_carry  (lane3_v0_carry)
    );

    // ===== Split v0 128-bit cho 4 lane (phục vụ VMERGE) =====
    // sew=8b : mỗi lane nhận 4 bit liên tiếp trong từng block 16 bit:
    //          lane0 [3:0], lane1 [7:4], lane2 [11:8], lane3 [15:12], ...
    // sew=16b: mỗi lane nhận 2 bit liên tiếp trong từng block 8 bit.
    // sew=32b: mỗi lane nhận 1 bit trong từng block 4 bit.
    reg [31:0] lane0_v0_merge_bits_r, lane1_v0_merge_bits_r, lane2_v0_merge_bits_r, lane3_v0_merge_bits_r;
    integer i;
    always_comb begin
        lane0_v0_merge_bits_r = 32'b0;
        lane1_v0_merge_bits_r = 32'b0;
        lane2_v0_merge_bits_r = 32'b0;
        lane3_v0_merge_bits_r = 32'b0;

        case (cfg_sew)
            3'd0: begin
                for (i = 0; i < 32; i = i + 1) begin
                    lane0_v0_merge_bits_r[i] = v0_mask_flat[(i * 4) + 0];
                    lane1_v0_merge_bits_r[i] = v0_mask_flat[(i * 4) + 1];
                    lane2_v0_merge_bits_r[i] = v0_mask_flat[(i * 4) + 2];
                    lane3_v0_merge_bits_r[i] = v0_mask_flat[(i * 4) + 3];
                end
            end
            3'd1: begin
                for (i = 0; i < 16; i = i + 1) begin
                    lane0_v0_merge_bits_r[(2*i)+0] = v0_mask_flat[(i * 8) + 0];
                    lane0_v0_merge_bits_r[(2*i)+1] = v0_mask_flat[(i * 8) + 1];
                    lane1_v0_merge_bits_r[(2*i)+0] = v0_mask_flat[(i * 8) + 2];
                    lane1_v0_merge_bits_r[(2*i)+1] = v0_mask_flat[(i * 8) + 3];
                    lane2_v0_merge_bits_r[(2*i)+0] = v0_mask_flat[(i * 8) + 4];
                    lane2_v0_merge_bits_r[(2*i)+1] = v0_mask_flat[(i * 8) + 5];
                    lane3_v0_merge_bits_r[(2*i)+0] = v0_mask_flat[(i * 8) + 6];
                    lane3_v0_merge_bits_r[(2*i)+1] = v0_mask_flat[(i * 8) + 7];
                end
            end
            default: begin
                for (i = 0; i < 32; i = i + 1) begin
                    lane0_v0_merge_bits_r[i] = v0_mask_flat[(i * 4) + 0];
                    lane1_v0_merge_bits_r[i] = v0_mask_flat[(i * 4) + 1];
                    lane2_v0_merge_bits_r[i] = v0_mask_flat[(i * 4) + 2];
                    lane3_v0_merge_bits_r[i] = v0_mask_flat[(i * 4) + 3];
                end
            end
        endcase
    end

    assign lane0_v0_merge_bits = vm_r ? 32'hFFFF_FFFF : lane0_v0_merge_bits_r;
    assign lane1_v0_merge_bits = vm_r ? 32'hFFFF_FFFF : lane1_v0_merge_bits_r;
    assign lane2_v0_merge_bits = vm_r ? 32'hFFFF_FFFF : lane2_v0_merge_bits_r;
    assign lane3_v0_merge_bits = vm_r ? 32'hFFFF_FFFF : lane3_v0_merge_bits_r;

    // ===== Reduction op decode + reduction unit =====
    // RVV 1.0 §14.1: all vred* share funct6[5:3]=000, distinguished by funct6[2:0].
    always_comb begin
        case (funct6_r[2:0])
            3'b000: reduction_operation = RED_SUM;    // vredsum.vs
            3'b001: reduction_operation = RED_AND;    // vredand.vs
            3'b010: reduction_operation = RED_OR;     // vredor.vs
            3'b011: reduction_operation = RED_XOR;    // vredxor.vs
            3'b100: reduction_operation = RED_MINU;   // vredminu.vs
            3'b101: reduction_operation = RED_MIN;    // vredmin.vs
            3'b110: reduction_operation = RED_MAXU;   // vredmaxu.vs
            3'b111: reduction_operation = RED_MAX;    // vredmax.vs
            default: reduction_operation = RED_SUM;
        endcase
    end

    vproc_reduction reduction_inst (
        .clk         (clk),
        .rst_n       (rst_n),
        .start       (fsm_reduction_start && is_reduction_r),
        .valid       (fsm_reduction_en && is_reduction_r),
        .vec0_128    (rs2_vec_flat),
        .vec1_128    (rs1_vec_flat),
        .mask_sel_128(v0_mask_flat),
        .sew         (cfg_sew),
        .operation   (reduction_operation),
        .done        (fsm_reduction_en && is_reduction_r && counter_done),
        .result_out  (reduction_result),
        .wb_valid    (reduction_wb_valid),
        .busy        (red_busy)
    );

    // ===== Mask write buffer =====
    // Ghi trong pha MASKING (FSM điều khiển bằng s_offset_en và cờ is_masking_r).
    vproc_mask_write_buffer mask_write_buffer_inst (
        .clk         (clk),
        .rst_n       (rst_n),
        .clear       (fsm_offset_reset),
        .in_valid    (fsm_s_offset_en && is_masking_r),
        .sew         (cfg_sew),
        .elems_curr_cycle(elems_curr_cycle_dbg),
        .index       (2'b00),
        .lane0_mask_in(lane_mask_result0),
        .lane1_mask_in(lane_mask_result1),
        .lane2_mask_in(lane_mask_result2),
        .lane3_mask_in(lane_mask_result3),
        .buffer_out  (mask_buffer_data),
        .wr_ptr_dbg  (mask_wr_ptr_dbg)
    );

    // ===== VLSU — Vector Load/Store Unit =====
    vproc_vec_lsu #(
        .VLEN      (128),
        .REG_AWIDTH(ADDR_WIDTH)
    ) vlsu_inst (
        .clk               (clk),
        .rst_n             (rst_n),
        // Issue
        .vls_valid         (vls_fire),
        .vls_is_load       (is_vls_load_raw),
        .vls_sew           (vls_sew_dec),
        .vls_vl            (csr_vl_o),
        .vls_vd_addr       (instruction[11:7]),   // vd (load) / vs3 (store)
        .rs1_data          (rs1_scalar_data),      // base address from scalar rs1
        .vm_i              (instruction[25]),       // vm bit: 1=unmasked, 0=masked
        .v0_flat_i         (v0_mask_flat),          // v0 mask register (128b)
        // VRF read (store source) — wrapper drives vs2_addr_to_vrf
        .vrf_lane0_rdata   (rs2_data_lane0),
        .vrf_lane1_rdata   (rs2_data_lane1),
        .vrf_lane2_rdata   (rs2_data_lane2),
        .vrf_lane3_rdata   (rs2_data_lane3),
        .vlsu_vrf_raddr    (vlsu_vrf_raddr_int),
        // Memory bus
        .mem_req           (vlsu_mem_req),
        .mem_we            (vlsu_mem_we),
        .mem_addr          (vlsu_mem_addr),
        .mem_be            (vlsu_mem_be),
        .mem_wdata         (vlsu_mem_wdata),
        .mem_rdata         (vlsu_mem_rdata),
        .mem_ready         (vlsu_mem_ready),       // from dmem_sync vlsu_ready
        // VRF write (load writeback)
        .vrf_we            (vlsu_vrf_we),
        .vrf_waddr         (vlsu_vrf_waddr),
        .vrf_wdata_l0      (vlsu_vrf_wdata_l0),
        .vrf_wdata_l1      (vlsu_vrf_wdata_l1),
        .vrf_wdata_l2      (vlsu_vrf_wdata_l2),
        .vrf_wdata_l3      (vlsu_vrf_wdata_l3),
        // Status
        .vlsu_busy         (vlsu_busy_int),
        .vlsu_busy_store   (vlsu_busy_store_int),
        .vls_done          ()   // unused; stall released via vlsu_busy → vpu_ready
    );

    // ===== 4 x VRF instances =====
    // write_en, wdata, vd are now routed through the VLSU/ALU mux (vrf_*_eff wires).
    // vs2 address is routed through vs2_addr_to_vrf for VLSU store reads.
    vproc_vregfile #(
        .NUM_REGS(NUM_REGS),
        .ADDR_WIDTH(ADDR_WIDTH)
    ) vrf_lane0 (
        .clk      (clk),
        .rst_n    (rst_n),
        .vs1      (vs1_addr_eff),
        .vs2      (vs2_addr_to_vrf),
        .vd       (vrf_waddr_eff),
        .write_en (vrf_we0_eff),
        .wdata    (vrf_wdata0_eff),
        .rs1_data (rs1_data_lane0),
        .rs2_data (rs2_data_lane0),
        .mask_data(mask_data_lane0)
    );

    vproc_vregfile #(
        .NUM_REGS(NUM_REGS),
        .ADDR_WIDTH(ADDR_WIDTH)
    ) vrf_lane1 (
        .clk      (clk),
        .rst_n    (rst_n),
        .vs1      (vs1_addr_eff),
        .vs2      (vs2_addr_to_vrf),
        .vd       (vrf_waddr_eff),
        .write_en (vrf_we1_eff),
        .wdata    (vrf_wdata1_eff),
        .rs1_data (rs1_data_lane1),
        .rs2_data (rs2_data_lane1),
        .mask_data(mask_data_lane1)
    );

    vproc_vregfile #(
        .NUM_REGS(NUM_REGS),
        .ADDR_WIDTH(ADDR_WIDTH)
    ) vrf_lane2 (
        .clk      (clk),
        .rst_n    (rst_n),
        .vs1      (vs1_addr_eff),
        .vs2      (vs2_addr_to_vrf),
        .vd       (vrf_waddr_eff),
        .write_en (vrf_we2_eff),
        .wdata    (vrf_wdata2_eff),
        .rs1_data (rs1_data_lane2),
        .rs2_data (rs2_data_lane2),
        .mask_data(mask_data_lane2)
    );

    vproc_vregfile #(
        .NUM_REGS(NUM_REGS),
        .ADDR_WIDTH(ADDR_WIDTH)
    ) vrf_lane3 (
        .clk      (clk),
        .rst_n    (rst_n),
        .vs1      (vs1_addr_eff),
        .vs2      (vs2_addr_to_vrf),
        .vd       (vrf_waddr_eff),
        .write_en (vrf_we3_eff),
        .wdata    (vrf_wdata3_eff),
        .rs1_data (rs1_data_lane3),
        .rs2_data (rs2_data_lane3),
        .mask_data(mask_data_lane3)
    );

    // ===== 4 x Processor lane =====
    vproc_processor_lane lane0 (
        .vs1_data        (rs1_data_lane0),
        .vs2_data        (rs2_data_lane0),
        .immediate       (imm_elem_vec),
        .rs1_data        (rs1_elem_vec),
        .funct6          (funct6_r),
        .sew             (cfg_sew),
        .vmask           (lane_mask0),
        .v0_carry        (lane0_v0_carry),
        .v0_merge_bits   (lane0_v0_merge_bits),
        .reverse_sub     (is_reverse_sub_r),
        .sub             (sub_r),
        .widen_sel       (fsm_widen_sel),
        .use_rs1         (use_rs1_r),
        .use_imm         (use_imm_r),
        .is_carry        (is_carry_r),
        .is_mask_carry   (is_mask_carry_r),
        .is_compare      (is_compare_r),
        .minmax_is_min   (minmax_is_min_r),
        .minmax_is_unsign(minmax_is_unsign_r),
        .is_unsigned_vs1 (is_u_vs1_r),
        .is_unsigned_vs2 (is_u_vs2_r),
        .is_mulh         (is_mulh_r),
        .wb_result       (wb_lane0),
        .mask_result_out (lane_mask_result0)
    );

    vproc_processor_lane lane1 (
        .vs1_data        (rs1_data_lane1),
        .vs2_data        (rs2_data_lane1),
        .immediate       (imm_elem_vec),
        .rs1_data        (rs1_elem_vec),
        .funct6          (funct6_r),
        .sew             (cfg_sew),
        .vmask           (lane_mask1),
        .v0_carry        (lane1_v0_carry),
        .v0_merge_bits   (lane1_v0_merge_bits),
        .reverse_sub     (is_reverse_sub_r),
        .sub             (sub_r),
        .widen_sel       (fsm_widen_sel),
        .use_rs1         (use_rs1_r),
        .use_imm         (use_imm_r),
        .is_carry        (is_carry_r),
        .is_mask_carry   (is_mask_carry_r),
        .is_compare      (is_compare_r),
        .minmax_is_min   (minmax_is_min_r),
        .minmax_is_unsign(minmax_is_unsign_r),
        .is_unsigned_vs1 (is_u_vs1_r),
        .is_unsigned_vs2 (is_u_vs2_r),
        .is_mulh         (is_mulh_r),
        .wb_result       (wb_lane1),
        .mask_result_out (lane_mask_result1)
    );

    vproc_processor_lane lane2 (
        .vs1_data        (rs1_data_lane2),
        .vs2_data        (rs2_data_lane2),
        .immediate       (imm_elem_vec),
        .rs1_data        (rs1_elem_vec),
        .funct6          (funct6_r),
        .sew             (cfg_sew),
        .vmask           (lane_mask2),
        .v0_carry        (lane2_v0_carry),
        .v0_merge_bits   (lane2_v0_merge_bits),
        .reverse_sub     (is_reverse_sub_r),
        .sub             (sub_r),
        .widen_sel       (fsm_widen_sel),
        .use_rs1         (use_rs1_r),
        .use_imm         (use_imm_r),
        .is_carry        (is_carry_r),
        .is_mask_carry   (is_mask_carry_r),
        .is_compare      (is_compare_r),
        .minmax_is_min   (minmax_is_min_r),
        .minmax_is_unsign(minmax_is_unsign_r),
        .is_unsigned_vs1 (is_u_vs1_r),
        .is_unsigned_vs2 (is_u_vs2_r),
        .is_mulh         (is_mulh_r),
        .wb_result       (wb_lane2),
        .mask_result_out (lane_mask_result2)
    );

    vproc_processor_lane lane3 (
        .vs1_data        (rs1_data_lane3),
        .vs2_data        (rs2_data_lane3),
        .immediate       (imm_elem_vec),
        .rs1_data        (rs1_elem_vec),
        .funct6          (funct6_r),
        .sew             (cfg_sew),
        .vmask           (lane_mask3),
        .v0_carry        (lane3_v0_carry),
        .v0_merge_bits   (lane3_v0_merge_bits),
        .reverse_sub     (is_reverse_sub_r),
        .sub             (sub_r),
        .widen_sel       (fsm_widen_sel),
        .use_rs1         (use_rs1_r),
        .use_imm         (use_imm_r),
        .is_carry        (is_carry_r),
        .is_mask_carry   (is_mask_carry_r),
        .is_compare      (is_compare_r),
        .minmax_is_min   (minmax_is_min_r),
        .minmax_is_unsign(minmax_is_unsign_r),
        .is_unsigned_vs1 (is_u_vs1_r),
        .is_unsigned_vs2 (is_u_vs2_r),
        .is_mulh         (is_mulh_r),
        .wb_result       (wb_lane3),
        .mask_result_out (lane_mask_result3)
    );

    // Debug: day la ngõ wb_result cua processor_lane (ALU), khong phai luon bang d/n ghi VRF.
    // Khi final_masking_commit (ST_FINAL_MASKING + is_final_masking), wdata = wb_lane*_mux
    // lay tu mask_buffer_data, trong khi wb_lane* van la ket hop ALU + vmask (co the khac / bang 0).
    assign wb_result_lane0 = wb_lane0;
    assign wb_result_lane1 = wb_lane1;
    assign wb_result_lane2 = wb_lane2;
    assign wb_result_lane3 = wb_lane3;

endmodule
