KhoiPham2402/RISCV-VPU32x/bench/tb_vproc_vmerge.sv

`timescale 1ns / 1ps

// VMERGE end-to-end test trên vproc_system_wrapper.
// - Cấu hình lần lượt e8/e16/e32 (m1, vl=4)
// - Nạp v0 (reg v0), v1 (vs1), v2 (vs2)
// - Issue VMERGE vv: vd=v3, vs2=v2, vs1=v1
// - So sánh kết quả ở VRF từng lane.

module tb_vproc_vmerge;
    localparam [6:0] OPCODE_OPV = 7'b101_0111;
    localparam [5:0] VMERGE     = 6'b010111;

    // zimm[7:0] = {vma,vta,vsew[2:0],vlmul[2:0]}, chọn m1.
    localparam [10:0] ZIMM_E8_M1  = 11'h0C0; // vsew=000, vlmul=000
    localparam [10:0] ZIMM_E16_M1 = 11'h0C8; // vsew=001, vlmul=000
    localparam [10:0] ZIMM_E32_M1 = 11'h0D0; // vsew=010, vlmul=000

    reg         clk;
    reg         rst_n;
    reg         instr_valid;
    reg [31:0]  instruction;
    reg [31:0]  rs1_scalar_data;
    reg [31:0]  rs2_scalar_data;
    reg         vrf_commit_en;

    wire [3:0]  cycles;
    wire [15:0] vmask16;
    wire        fifo_full;
    wire        busy;
    wire [2:0]  fsm_state;
    wire [31:0] wb_result_lane0, wb_result_lane1, wb_result_lane2, wb_result_lane3;
    wire        vpu_ready;
    wire        vpu_cfg_done;
    wire [31:0] vpu_vl_remain;
    wire [31:0] csr_vl_o;
    wire [31:0] csr_vtype_o;
    wire [31:0] csr_vlenb_o;
    wire [31:0] scalar_csr_rdata;

    integer pass_count;
    integer fail_count;

    vproc_system_wrapper dut (
        .clk             (clk),
        .rst_n           (rst_n),
        .instr_valid     (instr_valid),
        .instruction     (instruction),
        .rs1_scalar_data (rs1_scalar_data),
        .rs2_scalar_data (rs2_scalar_data),
        .vrf_commit_en   (vrf_commit_en),
        .cycles          (cycles),
        .vmask16         (vmask16),
        .fifo_full       (fifo_full),
        .busy            (busy),
        .fsm_state       (fsm_state),
        .wb_result_lane0 (wb_result_lane0),
        .wb_result_lane1 (wb_result_lane1),
        .wb_result_lane2 (wb_result_lane2),
        .wb_result_lane3 (wb_result_lane3),
        .vpu_ready       (vpu_ready),
        .vpu_cfg_done    (vpu_cfg_done),
        .vpu_vl_remain   (vpu_vl_remain),
        .csr_vl_o        (csr_vl_o),
        .csr_vtype_o     (csr_vtype_o),
        .csr_vlenb_o     (csr_vlenb_o),
        .scalar_csr_addr (12'h000),
        .scalar_csr_rdata(scalar_csr_rdata)
    );

    always #5 clk = ~clk;

    function automatic [31:0] build_opv(
        input [5:0] funct6,
        input       vm,
        input [2:0] funct3,
        input [4:0] vs1,
        input [4:0] vs2,
        input [4:0] vd
    );
        begin
            build_opv = 32'd0;
            build_opv[6:0]   = OPCODE_OPV;
            build_opv[11:7]  = vd;
            build_opv[14:12] = funct3;
            build_opv[19:15] = vs1;
            build_opv[24:20] = vs2;
            build_opv[25]    = vm;
            build_opv[31:26] = funct6;
        end
    endfunction

    function automatic [31:0] build_vsetvli(
        input [10:0] zimm11,
        input [4:0]  vd,
        input [4:0]  rs1_idx
    );
        begin
            build_vsetvli = 32'd0;
            build_vsetvli[6:0]   = OPCODE_OPV;
            build_vsetvli[14:12] = 3'b111;
            build_vsetvli[19:15] = rs1_idx;
            build_vsetvli[11:7]  = vd;
            build_vsetvli[30:20] = zimm11;
            build_vsetvli[31]    = 1'b0;
        end
    endfunction

    function automatic [31:0] vrf_word(input integer lane, input integer v);
        begin
            case (lane)
                0: vrf_word = {dut.vrf_lane0.bank3[v], dut.vrf_lane0.bank2[v], dut.vrf_lane0.bank1[v], dut.vrf_lane0.bank0[v]};
                1: vrf_word = {dut.vrf_lane1.bank3[v], dut.vrf_lane1.bank2[v], dut.vrf_lane1.bank1[v], dut.vrf_lane1.bank0[v]};
                2: vrf_word = {dut.vrf_lane2.bank3[v], dut.vrf_lane2.bank2[v], dut.vrf_lane2.bank1[v], dut.vrf_lane2.bank0[v]};
                3: vrf_word = {dut.vrf_lane3.bank3[v], dut.vrf_lane3.bank2[v], dut.vrf_lane3.bank1[v], dut.vrf_lane3.bank0[v]};
                default: vrf_word = 32'h0;
            endcase
        end
    endfunction

    task automatic vrf_write4(input integer v, input [31:0] w0, w1, w2, w3);
        begin
            {dut.vrf_lane0.bank3[v], dut.vrf_lane0.bank2[v], dut.vrf_lane0.bank1[v], dut.vrf_lane0.bank0[v]} = w0;
            {dut.vrf_lane1.bank3[v], dut.vrf_lane1.bank2[v], dut.vrf_lane1.bank1[v], dut.vrf_lane1.bank0[v]} = w1;
            {dut.vrf_lane2.bank3[v], dut.vrf_lane2.bank2[v], dut.vrf_lane2.bank1[v], dut.vrf_lane2.bank0[v]} = w2;
            {dut.vrf_lane3.bank3[v], dut.vrf_lane3.bank2[v], dut.vrf_lane3.bank1[v], dut.vrf_lane3.bank0[v]} = w3;
        end
    endtask

    task automatic issue(input [31:0] inst, input [31:0] rs1v, input [31:0] rs2v);
        begin
            @(negedge clk);
            instruction     = inst;
            rs1_scalar_data = rs1v;
            rs2_scalar_data = rs2v;
            instr_valid     = 1'b1;
            @(negedge clk);
            instr_valid     = 1'b0;
        end
    endtask

    task automatic wait_done;
        integer t;
        begin
            t = 0;
            while ((busy !== 1'b1) && (t < 200)) begin
                @(posedge clk);
                t = t + 1;
            end
            t = 0;
            while ((busy !== 1'b0) && (t < 2000)) begin
                @(posedge clk);
                t = t + 1;
            end
            if (t >= 2000) begin
                fail_count = fail_count + 1;
                $display("[FAIL] wait_done timeout");
            end
        end
    endtask

    task automatic check_lane4(
        input [255:0] tag,
        input [31:0] e0, e1, e2, e3
    );
        reg [31:0] g0, g1, g2, g3;
        begin
            g0 = vrf_word(0, 3);
            g1 = vrf_word(1, 3);
            g2 = vrf_word(2, 3);
            g3 = vrf_word(3, 3);
            if (g0 === e0 && g1 === e1 && g2 === e2 && g3 === e3) begin
                pass_count = pass_count + 1;
                $display("[PASS] %0s", tag);
            end else begin
                fail_count = fail_count + 1;
                $display("[FAIL] %0s", tag);
                $display("       got L0=%08h L1=%08h L2=%08h L3=%08h", g0, g1, g2, g3);
                $display("       exp L0=%08h L1=%08h L2=%08h L3=%08h", e0, e1, e2, e3);
            end
        end
    endtask

    task automatic dump_operands(input [255:0] tag);
        begin
            $display("---- %0s operands ----", tag);
            $display("v0 (mask): L0=%08h L1=%08h L2=%08h L3=%08h",
                vrf_word(0, 0), vrf_word(1, 0), vrf_word(2, 0), vrf_word(3, 0));
            $display("vs1 (v1):  L0=%08h L1=%08h L2=%08h L3=%08h",
                vrf_word(0, 1), vrf_word(1, 1), vrf_word(2, 1), vrf_word(3, 1));
            $display("vs2 (v2):  L0=%08h L1=%08h L2=%08h L3=%08h",
                vrf_word(0, 2), vrf_word(1, 2), vrf_word(2, 2), vrf_word(3, 2));
        end
    endtask

    task automatic dump_inst_and_regs(
        input [255:0] tag,
        input [31:0]  inst,
        input integer vd_idx,
        input integer vs1_idx,
        input integer vs2_idx
    );
        begin
            $display("==== %0s ====", tag);
            $display("inst = %08h | opcode=%02h funct3=%0h funct6=%02h vm=%0b vd=v%0d vs1=v%0d vs2=v%0d",
                inst, inst[6:0], inst[14:12], inst[31:26], inst[25], inst[11:7], inst[19:15], inst[24:20]);
            $display("v0  : L0=%08h L1=%08h L2=%08h L3=%08h",
                vrf_word(0, 0), vrf_word(1, 0), vrf_word(2, 0), vrf_word(3, 0));
            $display("vs1 : L0=%08h L1=%08h L2=%08h L3=%08h",
                vrf_word(0, vs1_idx), vrf_word(1, vs1_idx), vrf_word(2, vs1_idx), vrf_word(3, vs1_idx));
            $display("vs2 : L0=%08h L1=%08h L2=%08h L3=%08h",
                vrf_word(0, vs2_idx), vrf_word(1, vs2_idx), vrf_word(2, vs2_idx), vrf_word(3, vs2_idx));
            $display("vd(before): L0=%08h L1=%08h L2=%08h L3=%08h",
                vrf_word(0, vd_idx), vrf_word(1, vd_idx), vrf_word(2, vd_idx), vrf_word(3, vd_idx));
        end
    endtask
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
