KhoiPham2402/RISCV-VPU32x/(commit log)

2026-06-20 wip: pipeline sync + UART integration, benchmark charts, full project sync
    - 5-stage pipelined scalar core (pipelined_vpu.sv) with VPU dispatch
    - Sync IMEM/DMEM (imem_sync.sv, dmem_sync.sv), UART 8N1 TL-UL slave
    - riscv_vpu_top_v4: pipelined core + VPU + UART @ 0xFF000000
    - FPGA VGA demo: Lena Y-channel on DE10-Standard (hardware verified)
    - VLSU CSR stall bugfix (Issue #17): vle8.v no longer fires during vsetvli
    - Benchmark report: AXPY 1.43x, MatMul 2.71x, Lena BT.601 8.47x speedup
    - Benchmark charts (report/charts/): 7 PNG charts comparing scalar vs VPU
    - Add scalar benchmark programs: scalar_axpy.S, scalar_bt601.S
    - Update .gitignore: exclude .wlf, sof/, .claude/, modelsim.ini, *.bak
    Co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
    [c5_pin_model_dump.txt]
2026-06-20 docs: README, update status, sync vproc_system_wrapper CSR stall fix
    - README.md: full project documentation (architecture, sim commands,
    FPGA flow, benchmarks, design rules, open issues)
    - PROJECT_STATUS.md: update current phase, add benchmark summary table,
    add 2026-06-03/04 changelog entries
    - rtl/vproc_system_wrapper.sv: sync VLSU CSR stall fix from
    fpga/rtl/vpu/ (is_load_csr_stall guard prevents vle* firing while
    vsetvli is pending, fixes Issue #17 in simulation RTL)
    [vproc_system_wrapper.sv]
2026-08-02 fpga: fix critical decode/branch/forwarding bugs, redesign DMEM as shared bus, add Sobel benchmark
    RTL audit and cleanup (fpga/rtl/):
    - Fix swapped signed/unsigned branch comparison in brc.sv (BLT/BGE were
    unsigned, BLTU/BGEU were signed)
    - Fix control_unit.sv: RV32M (mul/div/rem) encodings silently aliased onto
    base ALU ops; now squashed via a new illegal_instr flag (M-extension
    itself still unimplemented)
    - Unify reset style (4 different conventions, incl. the register file) to
    synchronous active-low across 11 files
    - Remove dead tl_ul_xbar.sv/tl_ul_dmem_adapter.sv (zero references)
    - Style: always @(*) -> always_comb (41 occurrences); fix stale
    CTRL_WIDTH doc/default; add UART F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
    [brc.sv, control_unit.sv, d_ff.sv, dmem_arbiter.sv, dmem_model_sp.sv, dmem_qip_wrapper.sv, pipelined_vpu.sv]
